bengreff/lightsaders-turret-v4/README.md

# Turret v4 build pack

Lightsaders FTC, BIOBUZZ season: the v4 turret's build pack (lab checks, parts list, assembly steps, every print with its slicer supports) and its files: sliced Bambu H2D / H2C files, STLs, laser DXFs (1/4 in acetal) and a STEP for SolidWorks. Open `index.html` through GitHub Pages.

This repository is generated from the team's CAD tools; do not edit it by hand. `SHA256SUMS.txt` lists every file's checksum.
