bengreff/lightsaders-turret-v4/img/hero.png

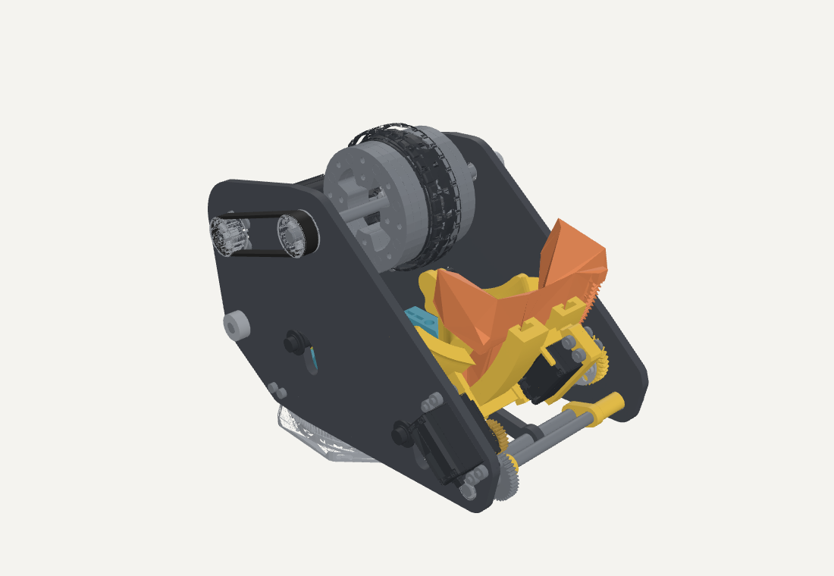
img/hero.png
