bengreff/lightsaders-turret-v4/plates/coupon.dxf

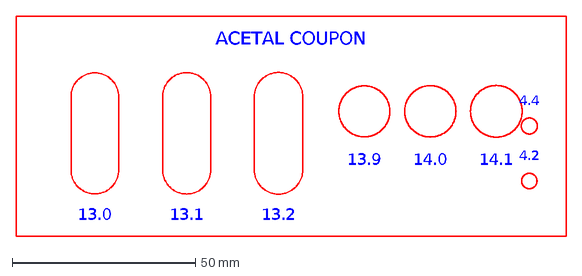
[picture p2: CAD file, 2026-11-11]
plates/coupon.dxf
ACETAL COUPON
13.0
13.1
13.2
13.9
14.0
14.1
4.2
4.4
