bengreff/lightsaders-turret-v4/print/H2C/ring.gcode.3mf

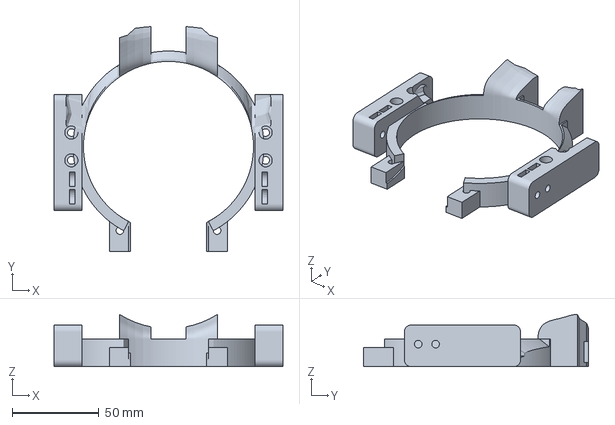
[picture p3: CAD file, 2026-11-11]
print/H2C/ring.gcode.3mf
132.0 x 129.6 x 30.2 mm
