bengreff/lightsaders-turret-v4/print/H2D/hood_teeth.gcode.3mf

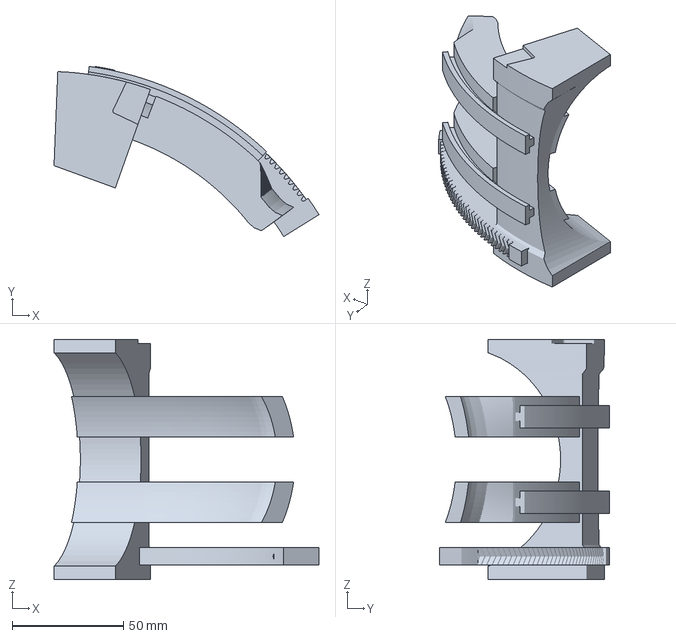
[picture p4: CAD file, 2026-11-11]
print/H2D/hood_teeth.gcode.3mf
119.0 x 76.5 x 108.0 mm
