bengreff/lightsaders-turret-v4/plates/plate_a.dxf

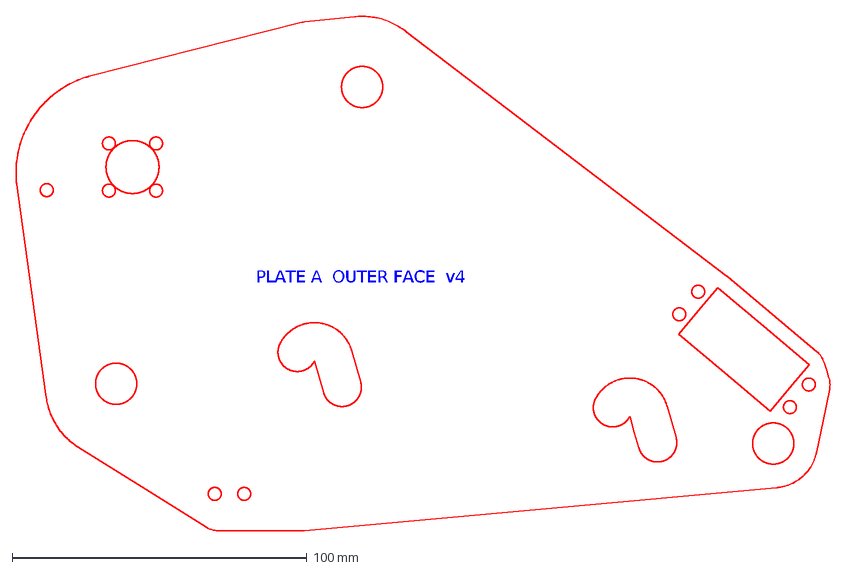
[picture p5: CAD file, 2026-11-11]
plates/plate_a.dxf
PLATE A OUTER FACE v4
