bengreff/lightsaders-turret-v4/print/H2C/crank_arm_a.gcode.3mf

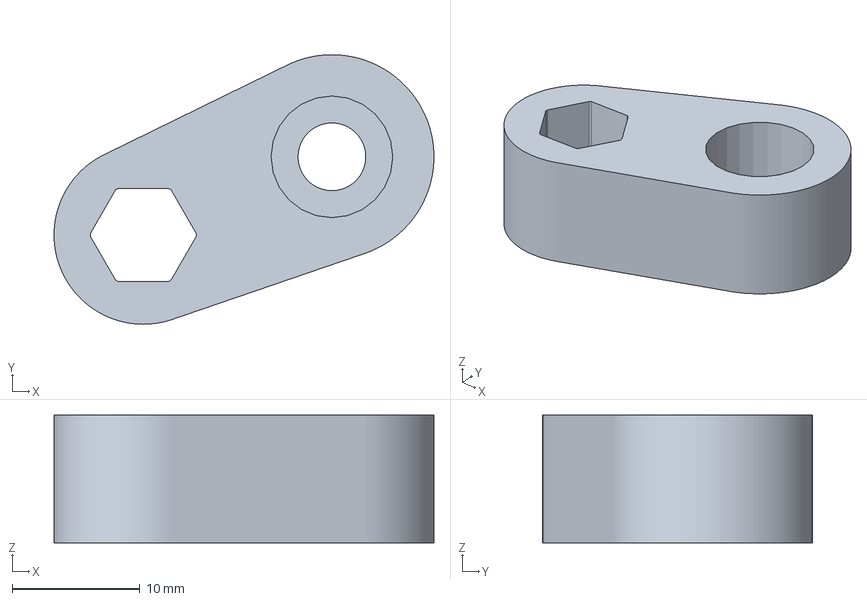
[picture p6: CAD file, 2026-11-11]
print/H2C/crank_arm_a.gcode.3mf
29.8 x 21.1 x 10.0 mm
