bengreff/lightsaders-turret-v4/print/H2D/gt2_pulley.gcode.3mf

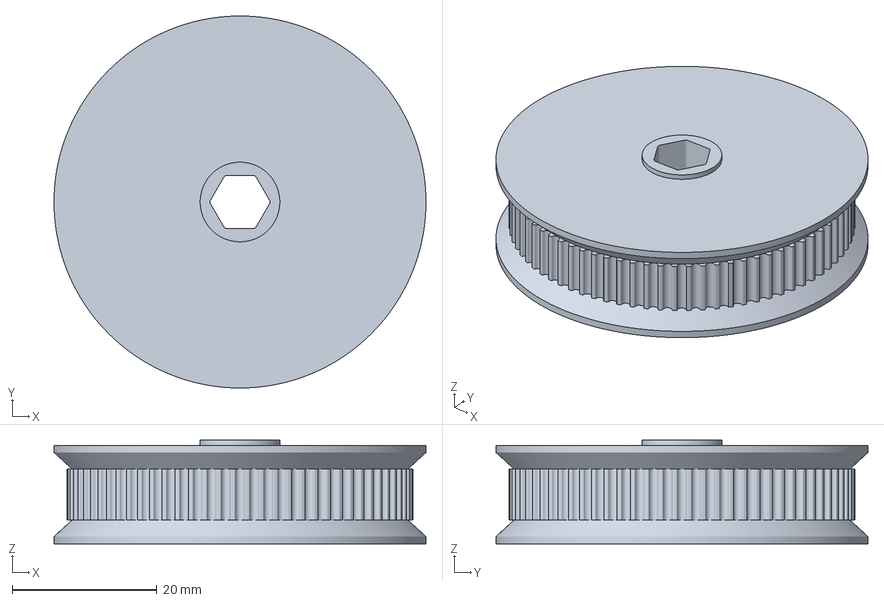
[picture p7: CAD file, 2026-11-11]
print/H2D/gt2_pulley.gcode.3mf
51.4 x 51.4 x 14.3 mm
