bengreff/lightsaders-turret-v4/plates/plate_b.dxf

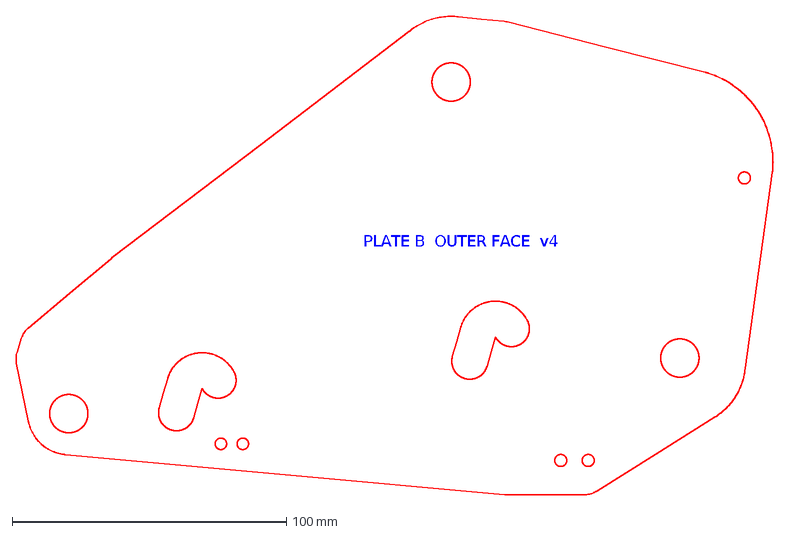
[picture p8: CAD file, 2026-11-11]
plates/plate_b.dxf
PLATE B OUTER FACE v4
