bengreff/lightsaders-turret-v4/print/crank_arm_b.stl

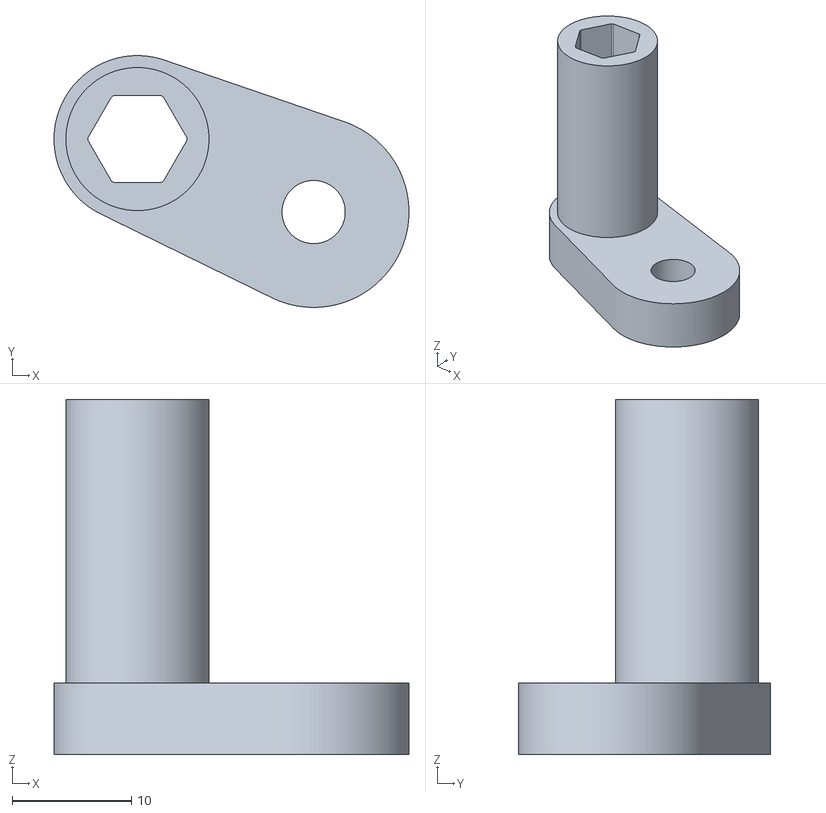
[picture p9: CAD file, 2026-11-11]
print/crank_arm_b.stl
29.8 x 21.1 x 29.8
