bengreff/lightsaders-turret-v4/plates/link.dxf

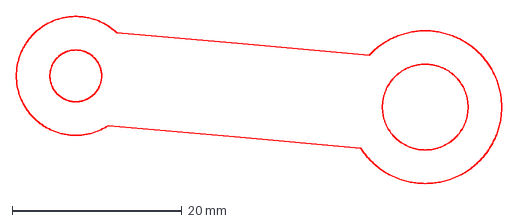
[picture p10: CAD file, 2026-11-11]
plates/link.dxf
57.2 x 19.7 mm
