bengreff/lightsaders-turret-v4/print/hood.stl

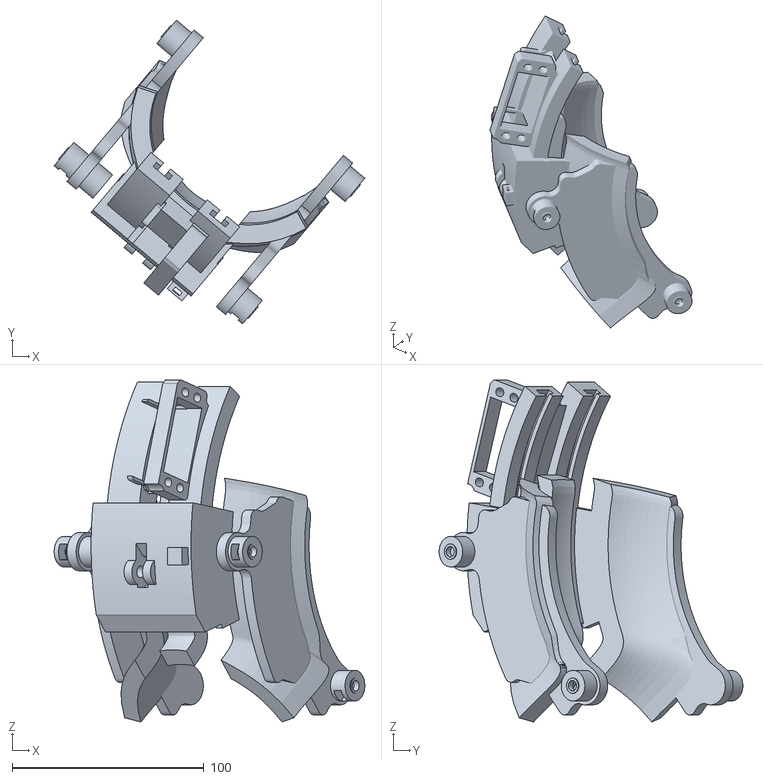
[picture p11: CAD file, 2026-11-11]
print/hood.stl
162.0 x 158.4 x 178.3
