bengreff/lightsaders-turret-v4/print/H2C/angle_pinion.gcode.3mf

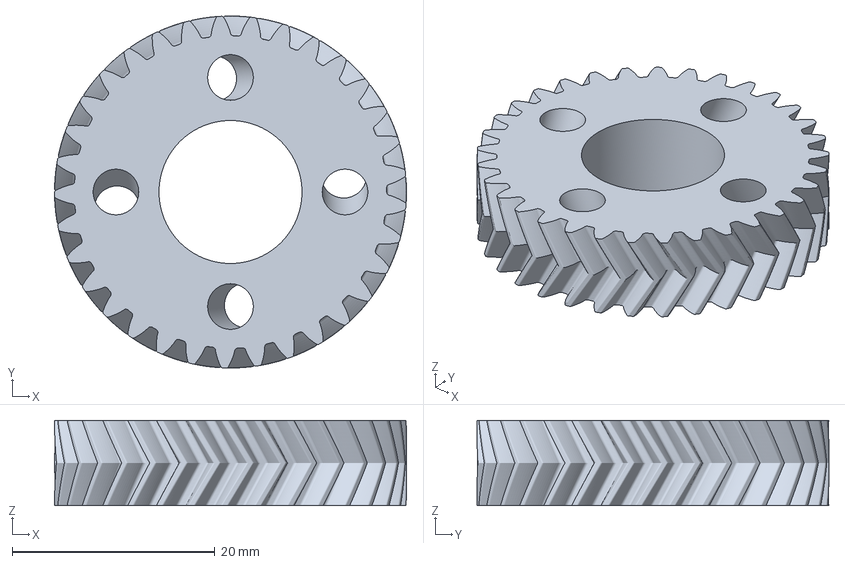
[picture p12: CAD file, 2026-11-11]
print/H2C/angle_pinion.gcode.3mf
34.7 x 34.7 x 8.40 mm
