bengreff/lightsaders-turret-v4/print/H2C/sector_coupon.gcode.3mf

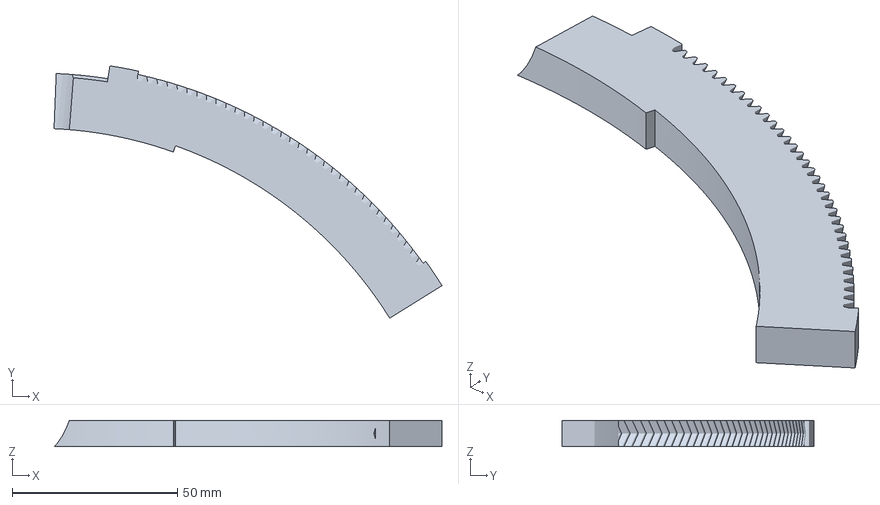
[picture p13: CAD file, 2026-11-11]
print/H2C/sector_coupon.gcode.3mf
117.5 x 76.4 x 7.88 mm
