bengreff/lightsaders-turret-v4/(list of files, cad)

Other CAD files:
print/ring.stl
print/hood_teeth.stl
print/H2C/crank_arm_b.gcode.3mf
print/H2D/crank_arm_b.gcode.3mf
print/H2C/hood_teeth.gcode.3mf
print/H2D/ring.gcode.3mf
print/crank_arm_a.stl
print/H2D/angle_pinion.gcode.3mf
print/gt2_pulley.stl
print/H2D/sector_coupon.gcode.3mf
print/H2C/gt2_pulley.gcode.3mf
print/H2D/crank_arm_a.gcode.3mf
print/sector_coupon.stl
print/angle_pinion.stl
print/H2C/hood.gcode.3mf
print/H2D/hood.gcode.3mf
