bengreff/lightsaders-turret-v4/img/print_angle_pinion_a.png

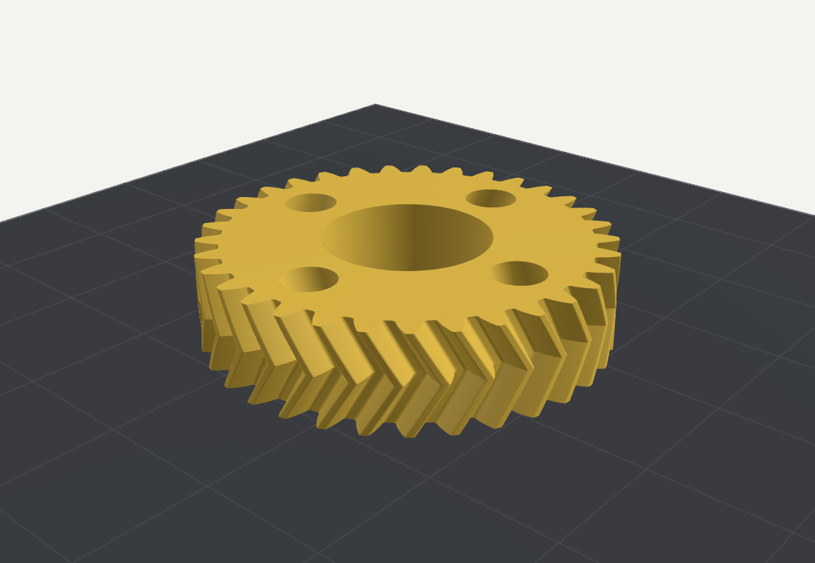
img/print_angle_pinion_a.png
