bengreff/lightsaders-turret-v4/img/print_angle_pinion_b.png

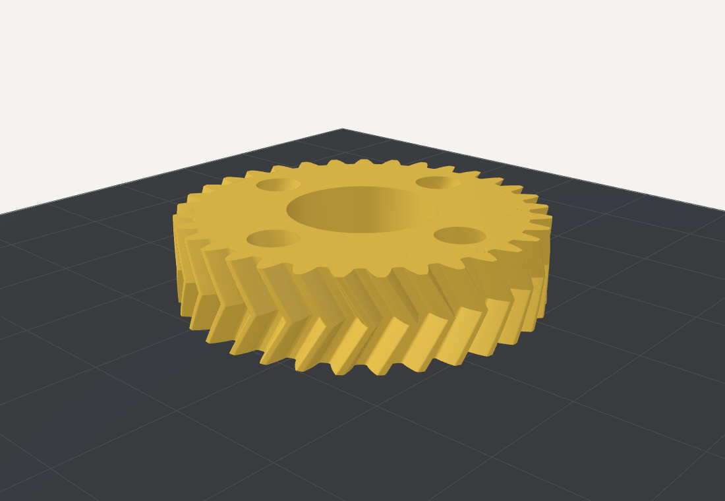
img/print_angle_pinion_b.png
