bengreff/lightsaders-turret-v4/img/print_crank_arm_a_a.png

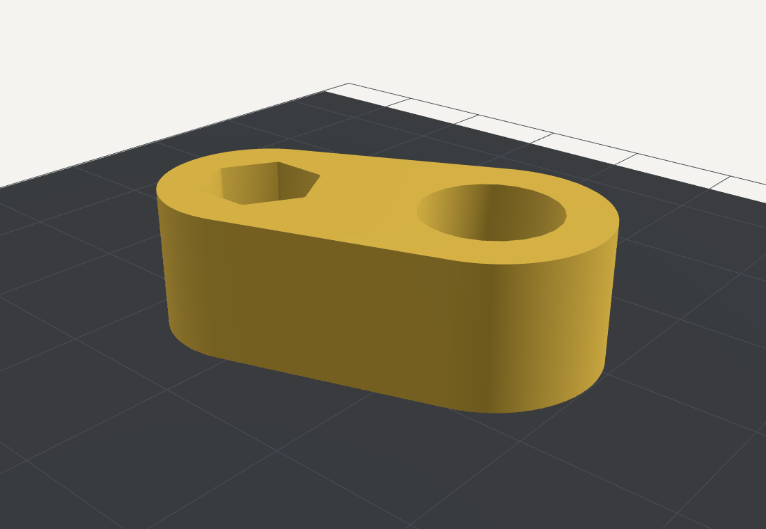
img/print_crank_arm_a_a.png
