bengreff/lightsaders-turret-v4/img/print_crank_arm_b_a.png

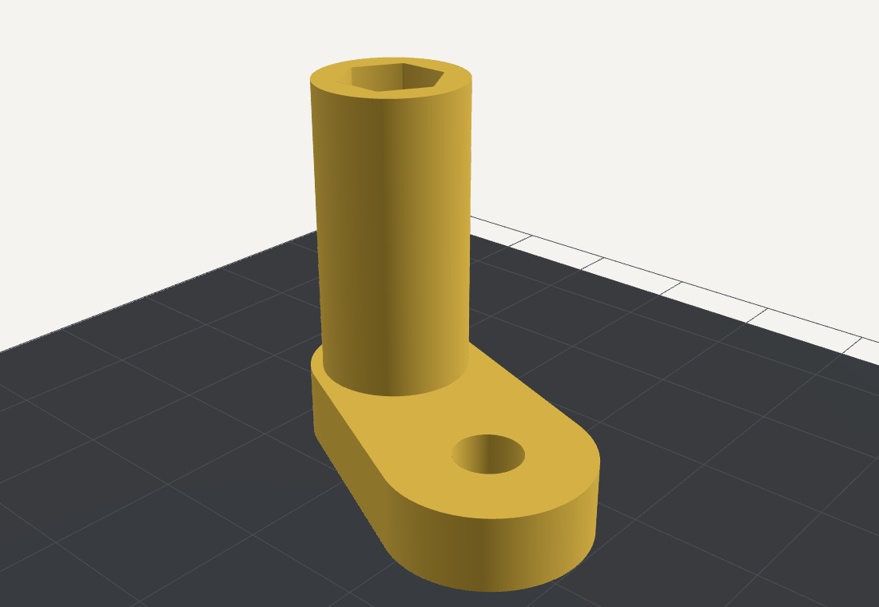
img/print_crank_arm_b_a.png
