bengreff/lightsaders-turret-v4/img/print_gt2_pulley_a.png

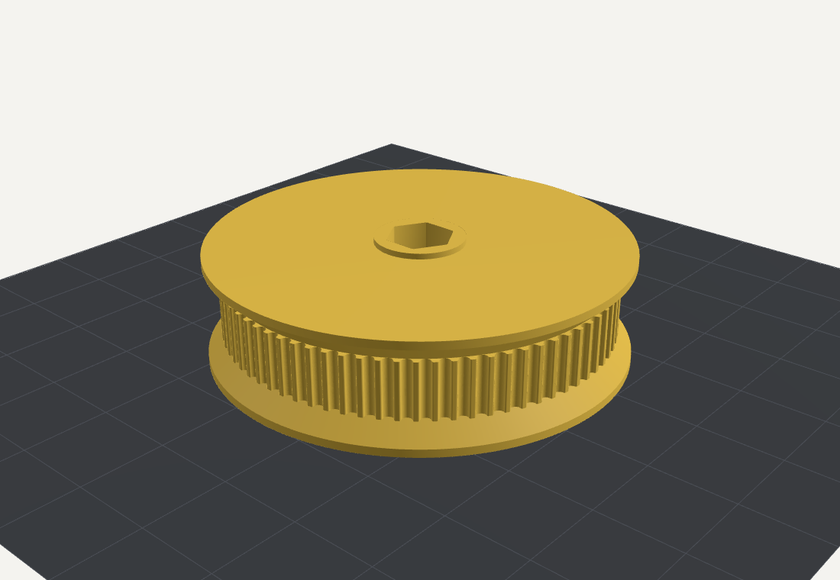
img/print_gt2_pulley_a.png
