bengreff/lightsaders-turret-v4/img/print_gt2_pulley_b.png

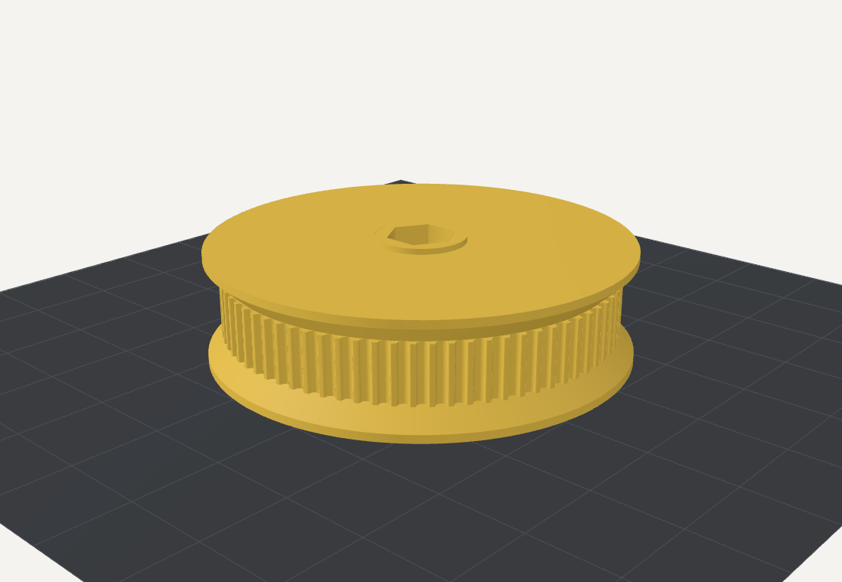
img/print_gt2_pulley_b.png
