bengreff/lightsaders-turret-v4/img/print_hood_teeth_a.png

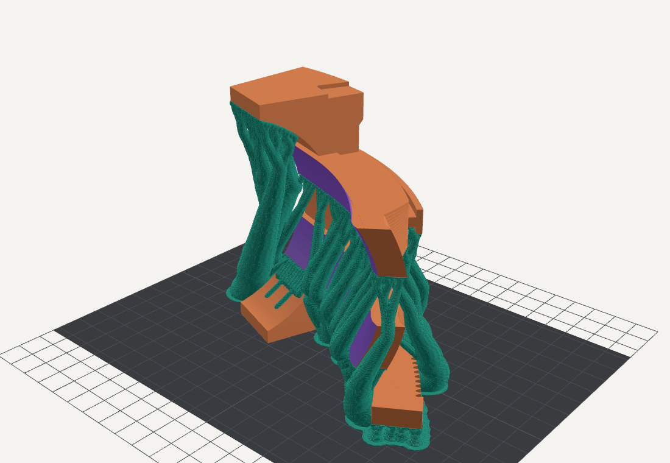
img/print_hood_teeth_a.png
