bengreff/lightsaders-turret-v4/img/print_hood_teeth_b.png

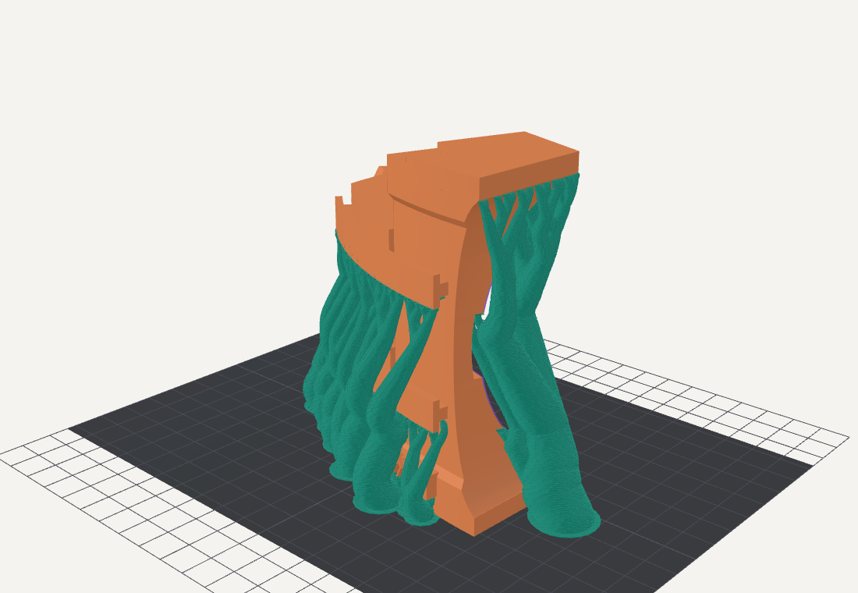
img/print_hood_teeth_b.png
