bengreff/lightsaders-turret-v4/img/print_ring_a.png

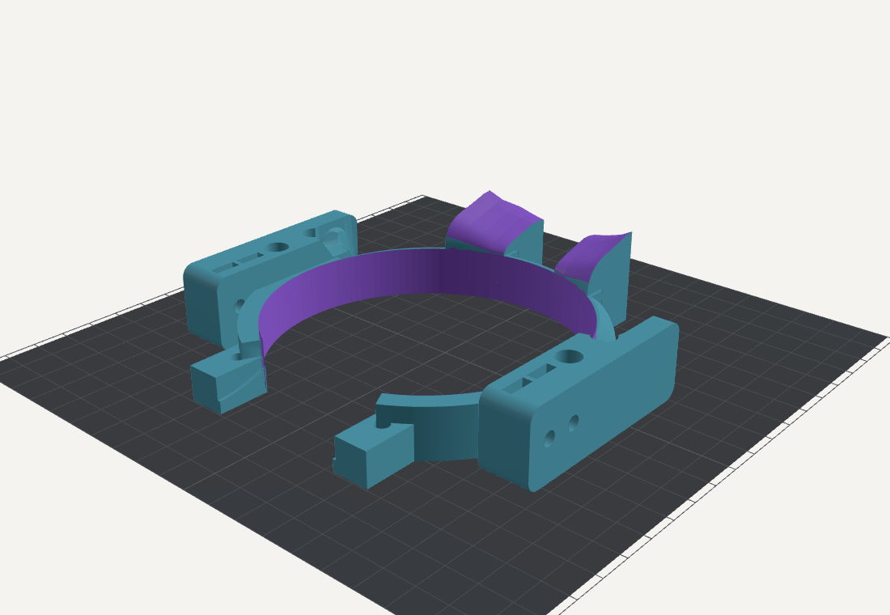
img/print_ring_a.png
