bengreff/lightsaders-turret-v4/img/print_ring_b.png

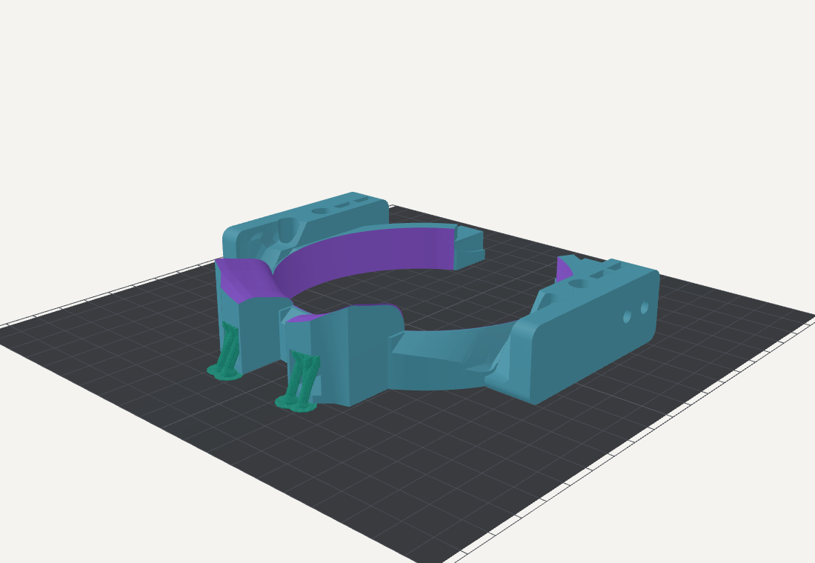
img/print_ring_b.png
