bengreff/lightsaders-turret-v4/img/print_sector_coupon_a.png

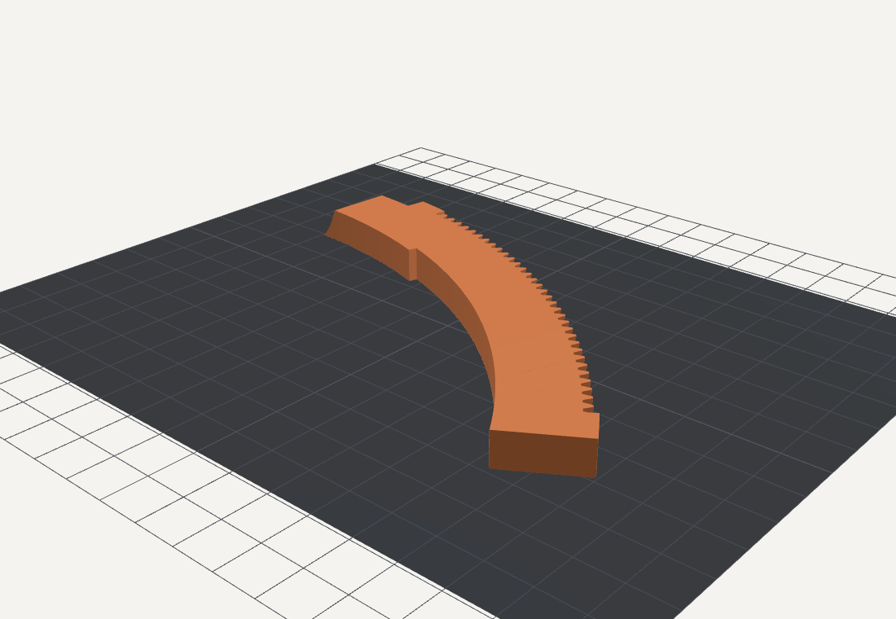
img/print_sector_coupon_a.png
