bengreff/lightsaders-turret-v4/img/print_sector_coupon_b.png

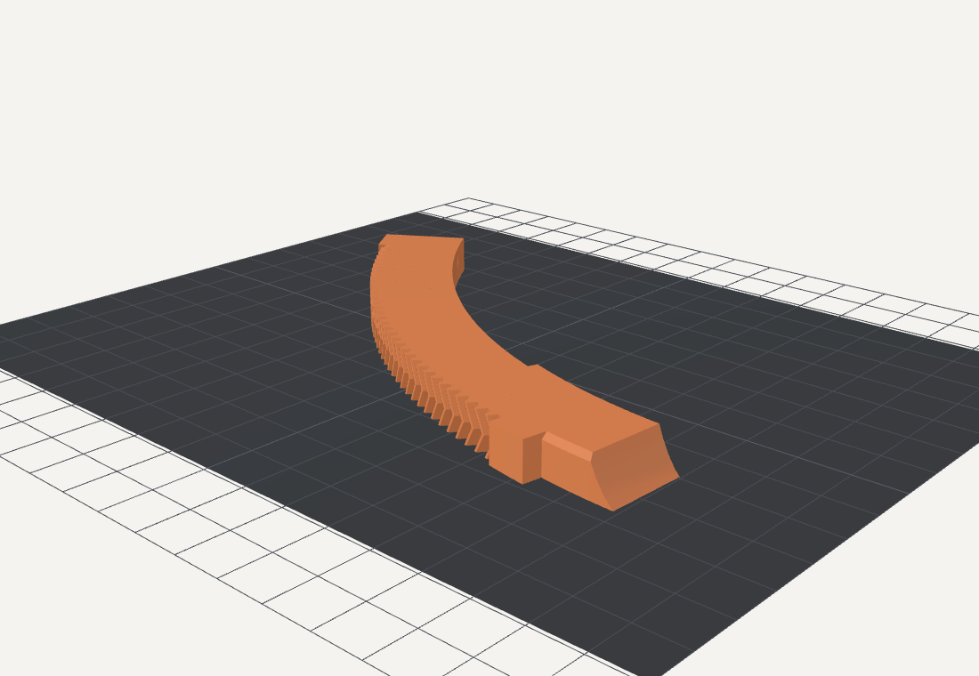
img/print_sector_coupon_b.png
