bengreff/lightsaders-turret-v4/img/step01.png

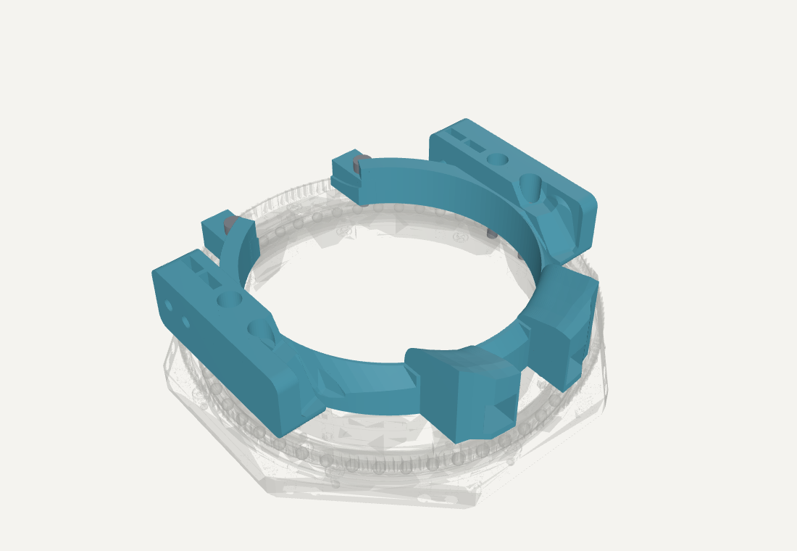
img/step01.png
