bengreff/lightsaders-turret-v4/img/step02.png

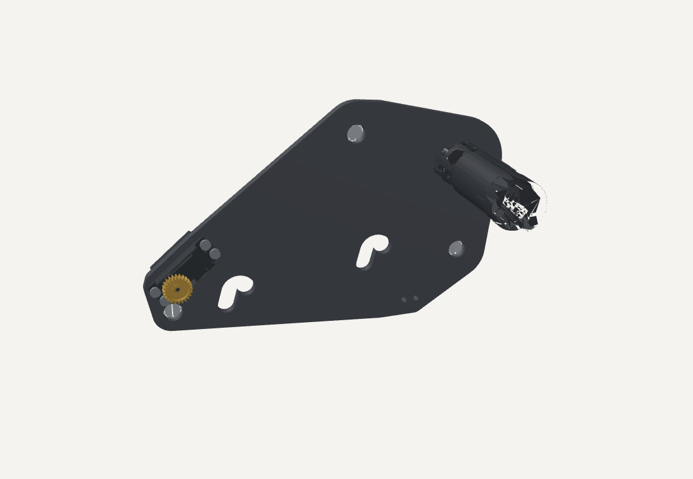
img/step02.png
