bengreff/lightsaders-turret-v4/img/step03.png

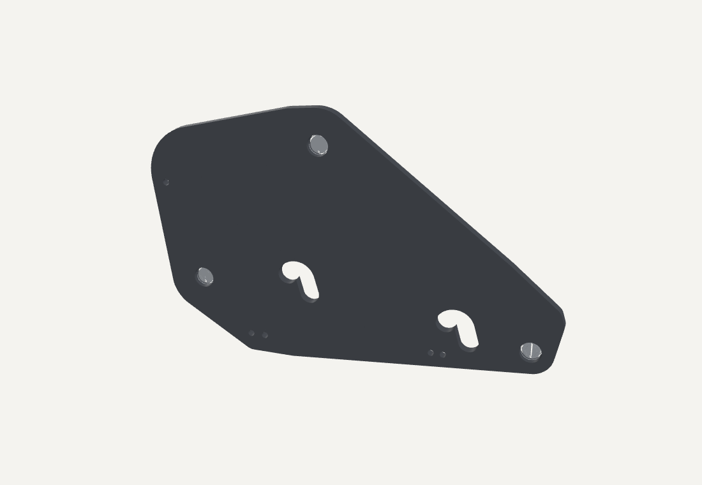
img/step03.png
