bengreff/lightsaders-turret-v4/img/step04.png

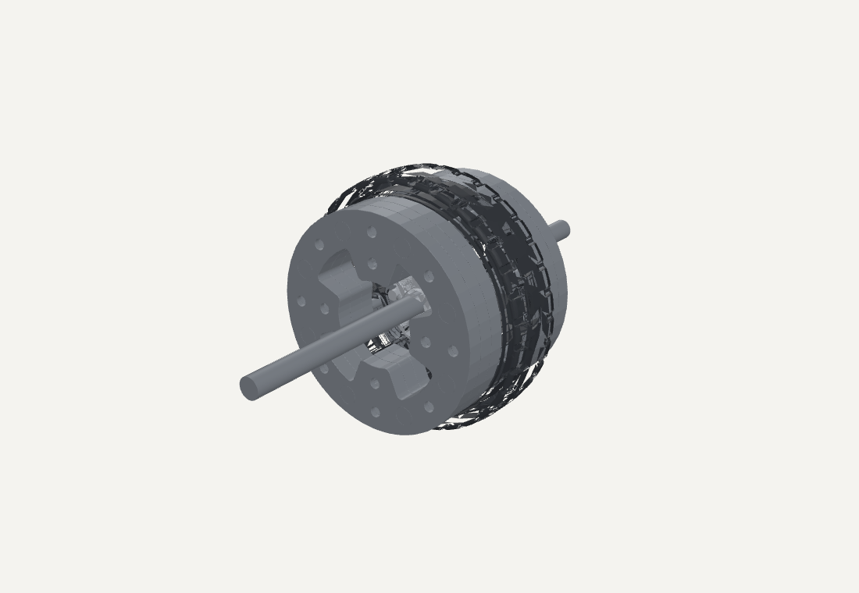
img/step04.png
