bengreff/lightsaders-turret-v4/img/step05.png

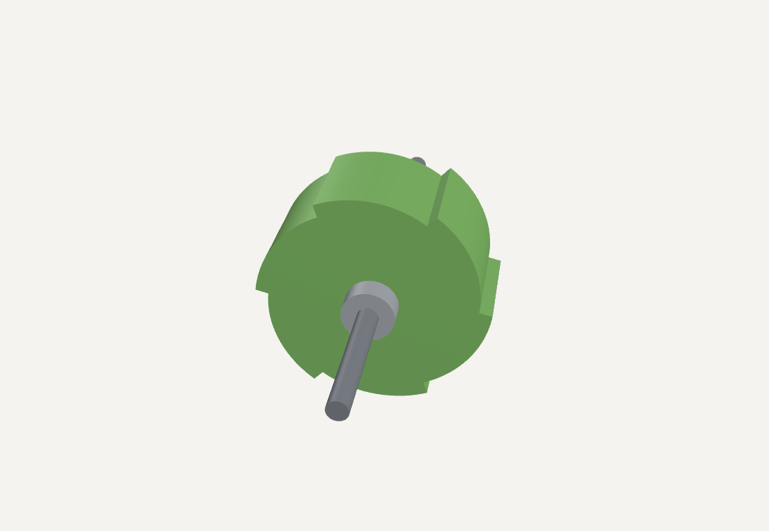
img/step05.png
