bengreff/lightsaders-turret-v4/img/step06.png

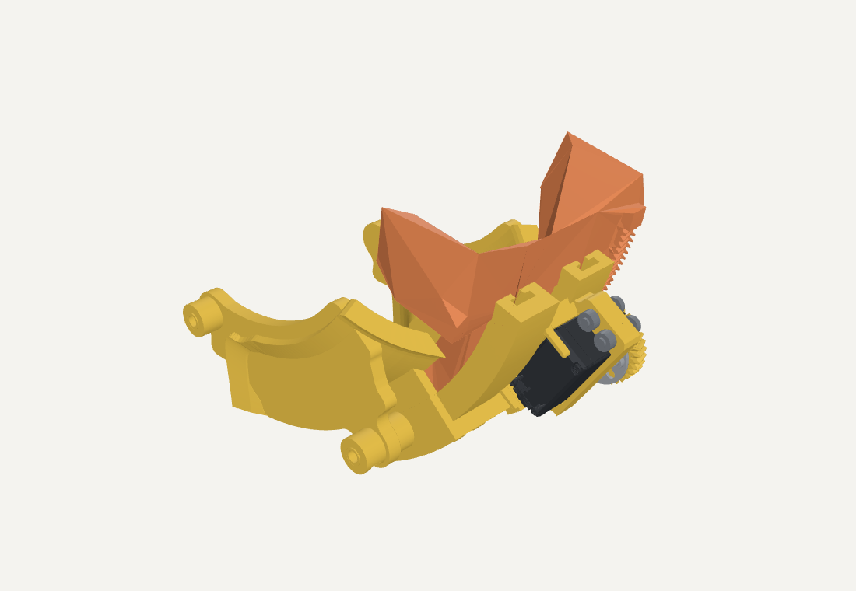
img/step06.png
