bengreff/lightsaders-turret-v4/img/step07.png

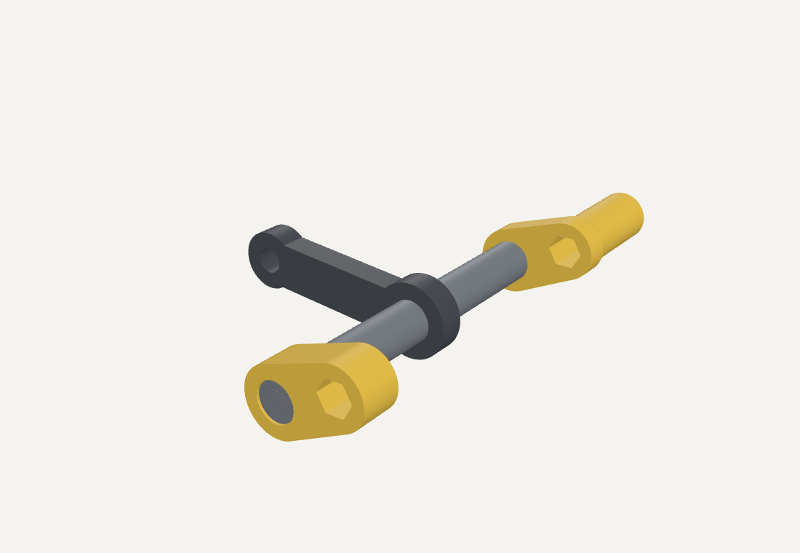
img/step07.png
