bengreff/lightsaders-turret-v4/img/step08.png

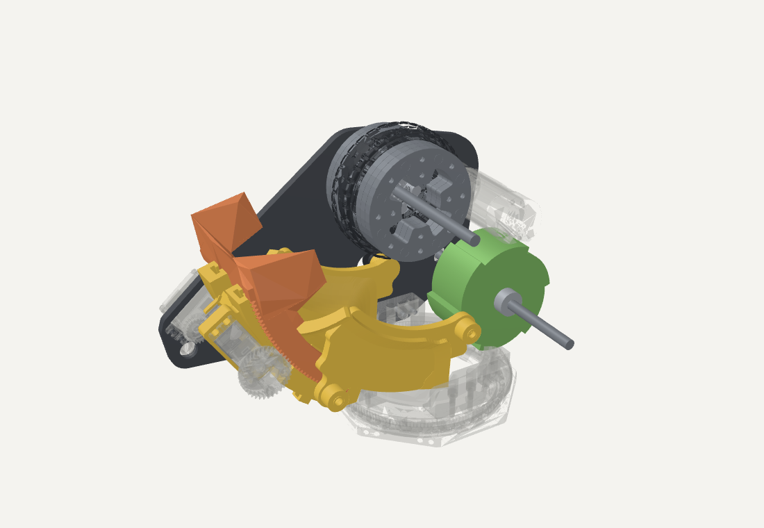
img/step08.png
