bengreff/lightsaders-turret-v4/img/step09.png

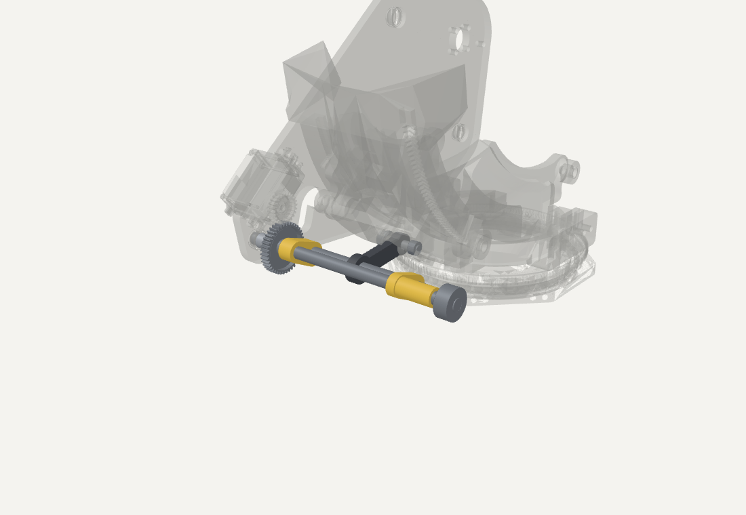
img/step09.png
