bengreff/lightsaders-turret-v4/img/step10.png

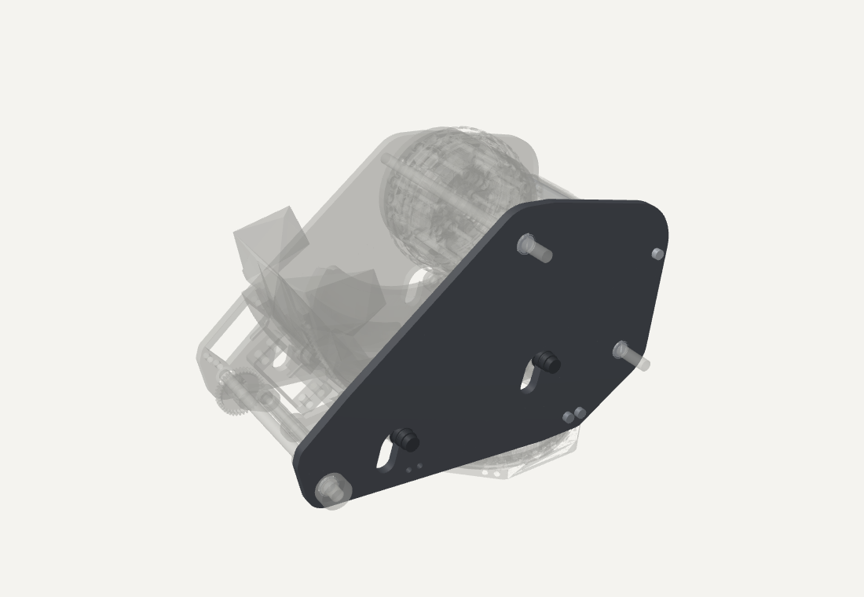
img/step10.png
