bengreff/lightsaders-turret-v4/img/step11.png

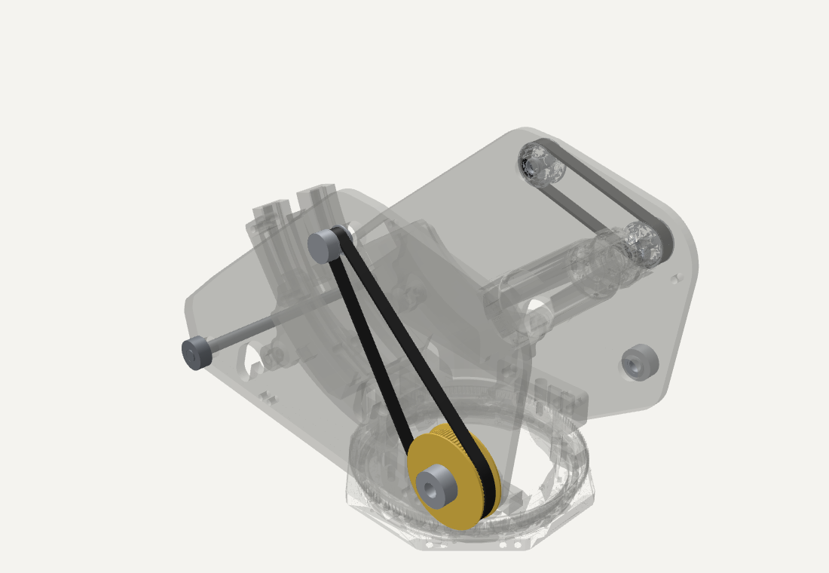
img/step11.png
