bengreff/lightsaders-turret-v4/img/step12.png

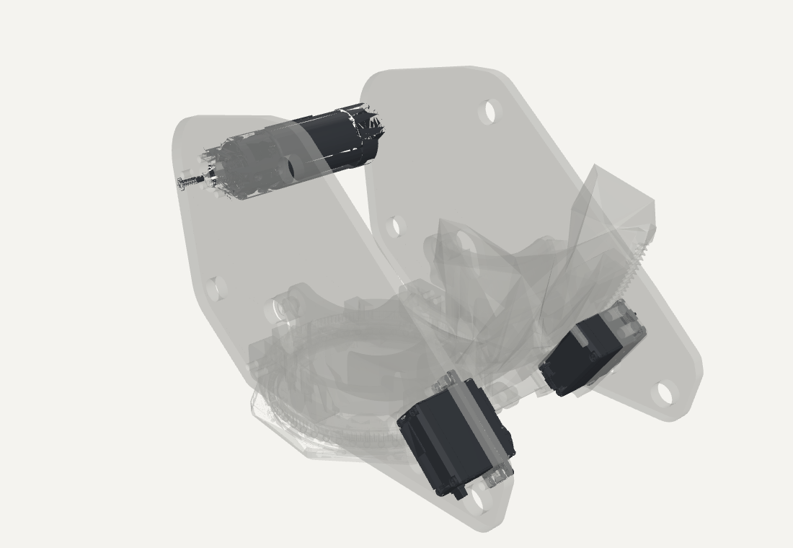
img/step12.png
