bengreff/lightsaders-turret-v4/(commit log)

2026-11-11 Turret v4 build pack: page, prints (H2D + H2C slices, STLs), laser DXFs, STEP for SolidWorks (zipped), parts CSV, 3D views
    [angle_pinion.gcode.3mf, angle_pinion.stl, coupon.dxf, crank_arm_a.gcode.3mf, crank_arm_a.stl, crank_arm_b.gcode.3mf, crank_arm_b.stl, gt2_pulley.gcode.3mf]
2026-11-11 Squishy wheel straight on its REX shaft: the printed flanges and M3 screws removed (CAD, parts list, step 5, STEP)
    [coupon.dxf, link.dxf, plate_a.dxf, plate_b.dxf, squishy_flange.gcode.3mf, squishy_flange.stl, turret_v4_parts.csv]
